bgamari/bike-trailer/parts.ods

Sheet: parts
 |  |  | Cost |  | Weight (pounds)
Qty | Size | Unit | Per unit | Total | Per unit | Total | Source | Part no. | Description
2 |  | pack of 50 | $8.50 | $17.00 | 0.0080 | 0.0 | McMaster | 92095A224 | M6 10mm rounded head screws
100 |  | each | $0.32 | $32.00 | 0.0080 | 0.8 | 80/20 | 14124 | M6 T-nut block
4 | 26 | inch | $0.21 | $21.84 | 0.0415 | 4.3 | 80/20 | 25-2525 | 26” 2525 extrusion
2 | 30 | inch | $0.21 | $12.60 | 0.0415 | 2.5 | 80/20 | 25-2525 | 30” 2525 extrusion
4 |  | each | $6.80 | $27.20 | 0.0475 | 0.2 | 80/20 | 25-4140 | wheel brackets
4 |  | each | $6.30 | $25.20 | 0.1000 | 0.4 | 80/20 | 25-4151 | 90-degree flat plate
4 |  | each | $4.30 | $17.20 | 0.0360 | 0.1 | 80/20 | 25-4118 | Three hole straight flat plate (for underside of inner corners)
4 |  | each | $1.80 | $7.20 | 0.0266 | 0.1 | 80/20 | 14058 | Inside corner bracket (4 exterior corners)
2 |  | each | $33.00 | $66.00 | 1.6500 | 3.3 | elsewhere |  | Wheels
Feet
2 |  | each | $3.95 | $7.90 | 0.0310 | 0.1 | 80/20 | 25-4132 | Inside corner bracket (stronger)
2 |  | each | $2.90 | $5.80 | 0.0210 | 0.0 | 80/20 | 25-4119 | Inside corner bracket
2 | 15 | inch | $0.16 | $4.80 | 0.0247 | 0.7 | 80/20 | 20-2020 | Extrusion with 30 degree mitre
Tongue
1 |  | each | $15.67 | $15.67 |  | 0.0 | McMaster | 4568T17 | 1ft 1.25” wide aluminum hex extrusion
1 | 66 | inch | $0.16 | $10.56 | 0.0247 | 1.6 | 80/20 | 20-2020 | Aluminum extrusion (kayak tongue)
1 | 18 | inch | $0.16 | $2.88 |  |  | 80/20 | 20-2020 | Aluminum extrusion (short tongue)
1 | 18 | inch | $0.16 | $2.88 | 0.0247 | 0.4 | 80/20 | 20-2020 | Aluminum extrusion (outward angle)
24 |  | each | $0.21 | $5.04 | 0.0030 | 0.1 | 80/20 | 14122 | M5 T-nut block
2 |  | each | $5.10 | $10.20 | 0.0860 | 0.2 | 80/20 | 4145 | Four hole 45-degree flat plate
2 |  | each | $6.30 | $12.60 | 0.1190 | 0.2 | 80/20 | 25-4151 | 90-degree flat plate
2 |  | each | $6.80 | $13.60 | 0.0457 | 0.1 | 80/20 | 25-4140 | Tee plate
2 |  | each | $4.80 | $9.60 | 0.0500 | 0.1 | 80/20 | 25-4117 | 4 hole straight flat plate
Total |  |  |  | $327.77 |  | 15.3

Sheet: fasteners
M6 screws
12 | per inner corner | 4 | 48
4 | per outer corner | 4 | 16
6 | wheel | 2 | 12
6 | tongue | 1 | 6
2 | per foot | 2 | 4
Total |  |  | 82
M5 screws
4 | tongue | 1 | 4
8 | 45 degree corner | 1 | 8
4 | 90 degree corner | 1 | 4
Total |  |  | 16
