bgamari/bike-trailer/trailer.dxf

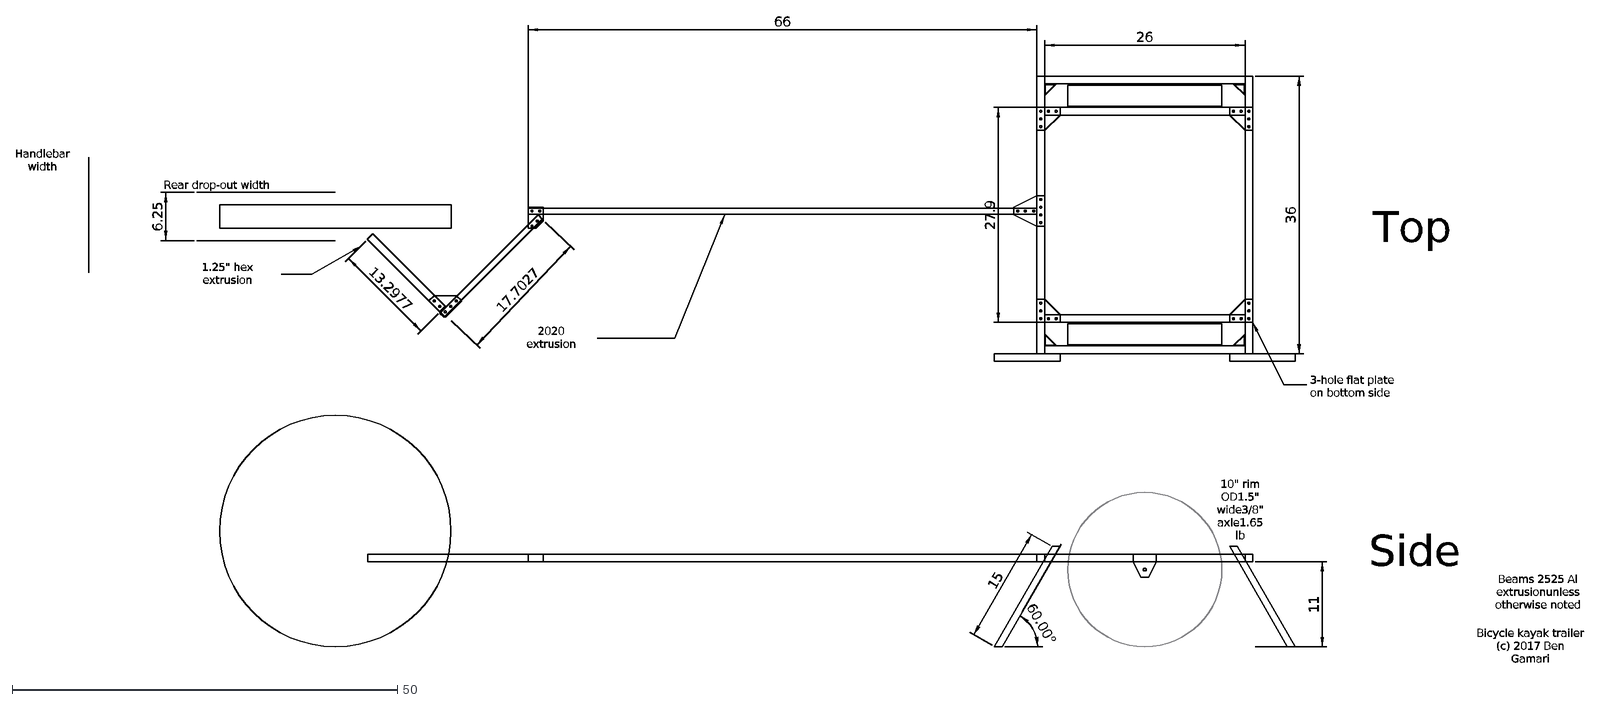
[picture p1: CAD file, 2017-05-24]
trailer.dxf
Side
10" rim OD 1.5" wide 3/8" axle 1.65 lb
Bicycle kayak trailer (c) 2017 Ben Gamari
15
Beams 2525 Al extrusion unless otherwise noted
6.25
Rear drop-out width
2020 extrusion
17.7027
1.25" hex extrusion
60.00°
11
66
13.2977
Handlebar width
Top
3-hole flat plate on bottom side
36
26
27.9
