bgamari/bike-trailer/(commit log)

2017-04-25 Update drawing
    [trailer.dxf]
2017-04-25 Add parts list
    [parts.ods]
2017-05-06 Ordered design
    [parts.ods, trailer.dxf]
2017-05-20 Stand bracket
    [stand-bracket.scad]
2017-05-20 Parts list
    [parts.ods]
2017-05-20 Final drawing
    [trailer.dxf]
2017-05-21 Axle mount
    Printed once, hole widened to accomodate 15mm socket
    [axle-mount.scad]
2017-05-23 Tweaking of axle mount
    [axle-mount.scad]
2017-05-24 More work on drawing
    [trailer.dxf]
2017-06-03 Add bow-vee
    [bow-v.scad]
2017-06-03 Add tongue adapter
    [tongue-adapter.scad]
2017-06-08 Add spacer
    [spacer.scad]
2017-06-08 Rework bow V
    [bow-v.scad]
2017-06-08 Front tongue adapter
    [tongue-adapter.scad]
2017-06-10 Add hook
    [hook.scad]
